Zychlix/Geiger/kluczowanie_i_sprzezenie.png

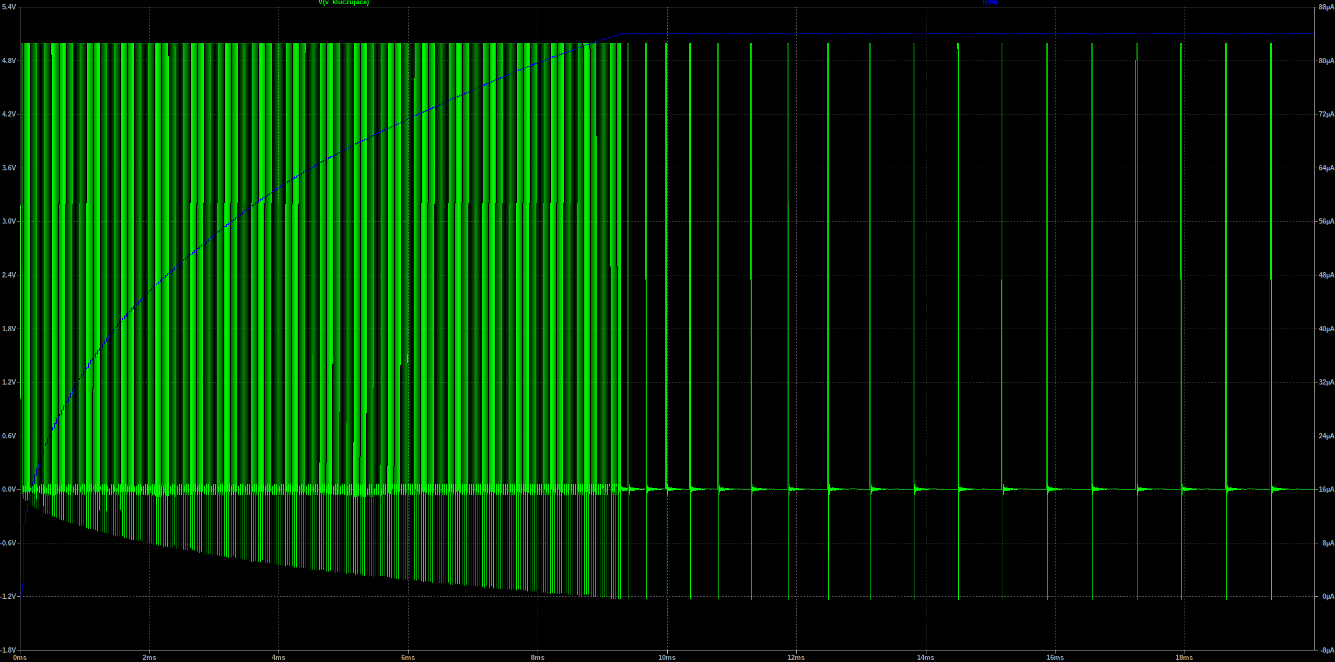
kluczowanie_i_sprzezenie.png
