Zychlix/Geiger/LGM-01_pomocnicze/schemat.png

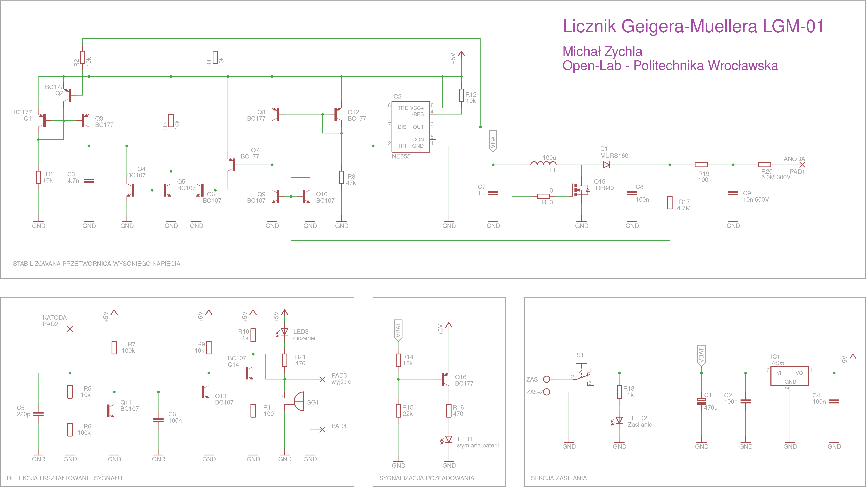
LGM-01_pomocnicze/schemat.png
