Zychlix/Geiger/oscylator.png

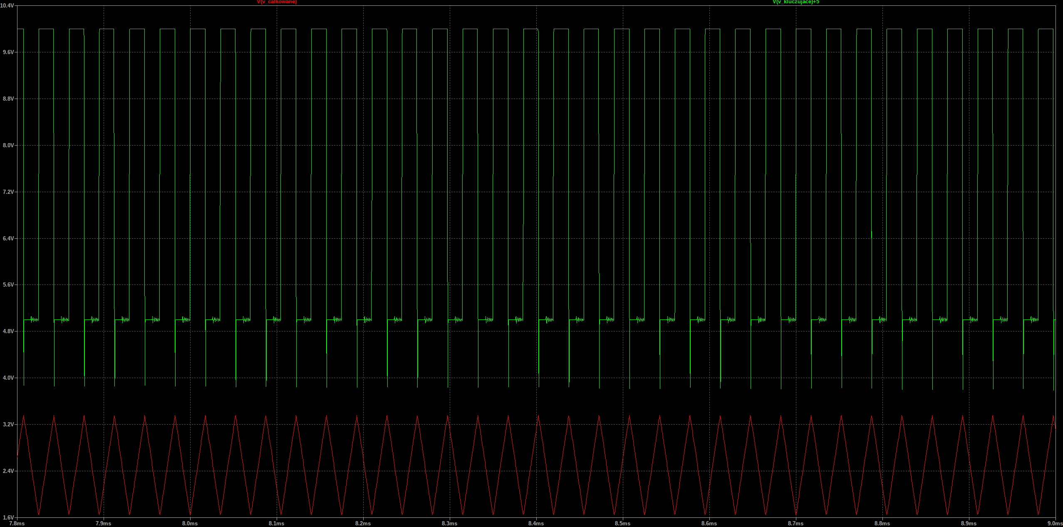
oscylator.png
