Zychlix/Geiger/załączenie_20C_bez_rl.png

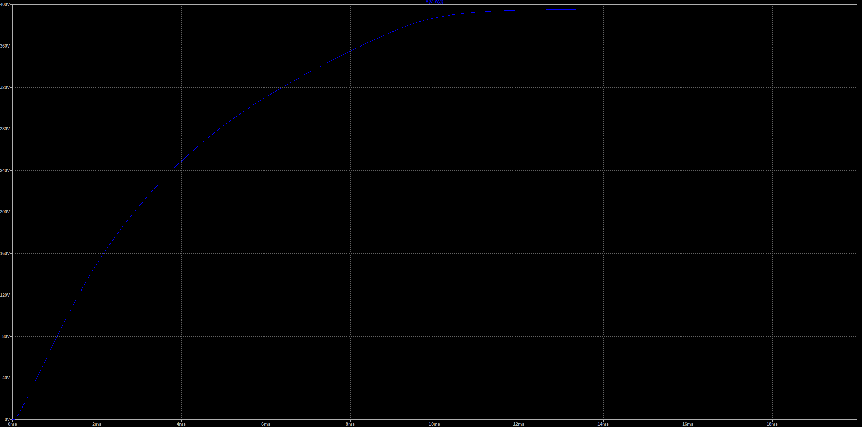
załączenie_20C_bez_rl.png
