Zychlix/Geiger/ładowanie_i_rozładowywanie.png

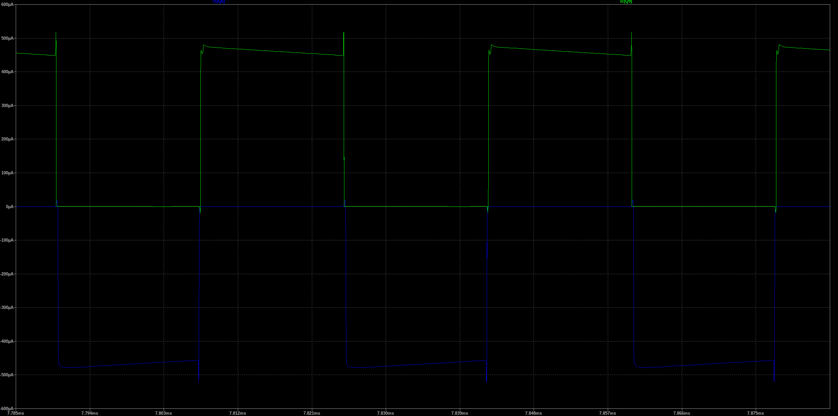
ładowanie_i_rozładowywanie.png
