Zychlix/Geiger/ładowanie_i_rozładowywanie_fb.png

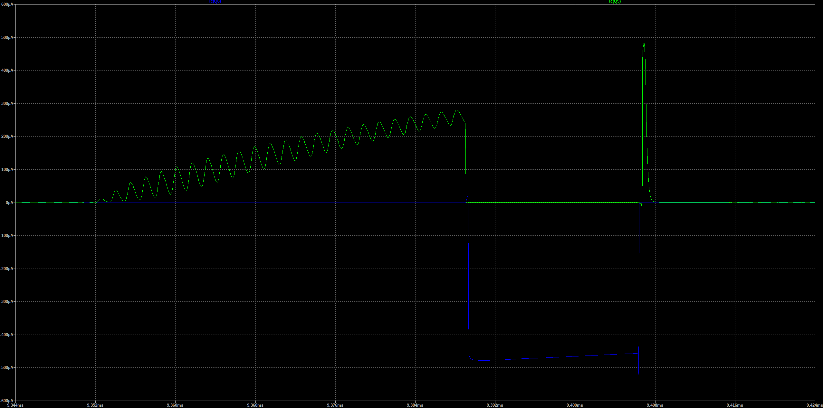
ładowanie_i_rozładowywanie_fb.png
