Zychlix/Geiger/LGM-01_pomocnicze/licznik.pdf

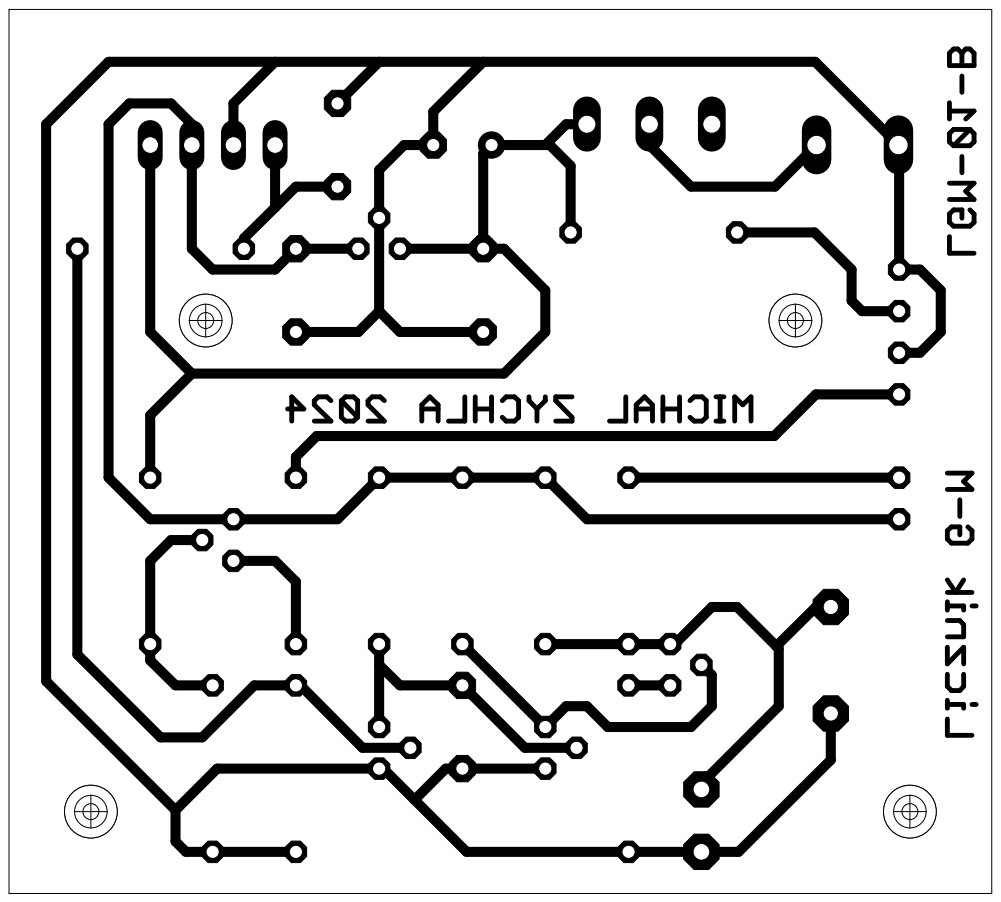
[picture p7: page 1]
