Zychlix/Geiger/LGM-01_przetwornica/licznik.pdf

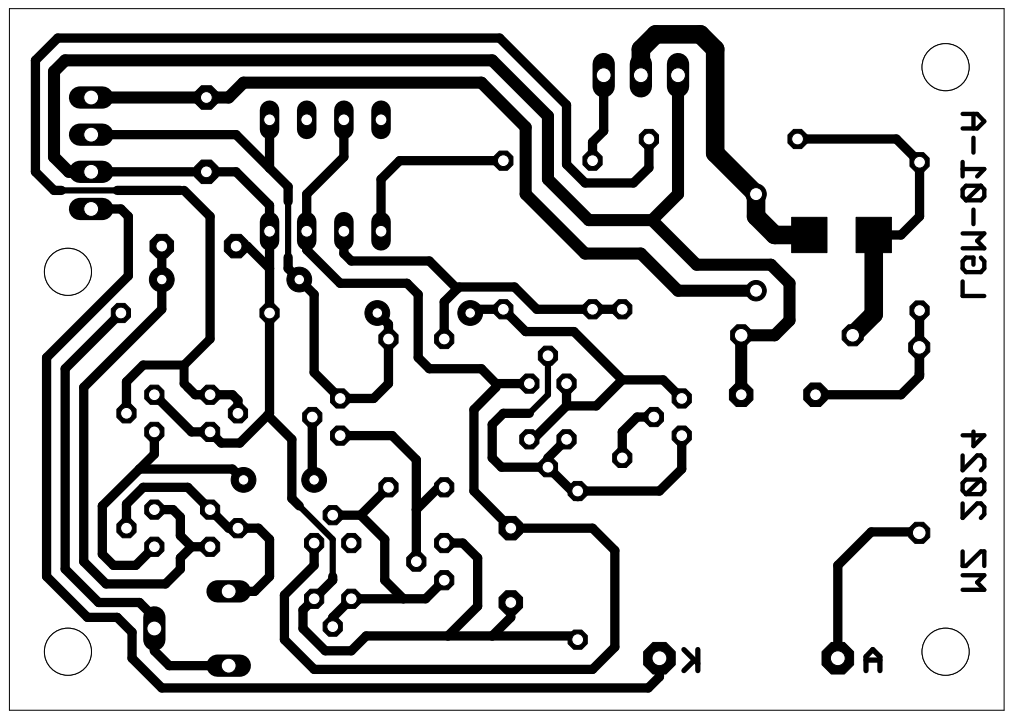
[picture p8: page 1]
