Zychlix/Geiger/dodatkowe.asc

C1: cap; 10n
C2: cap; 330p
C3: cap; 100n
D1: LED; L1C1-DRD1000000000
I1: current; PULSE(0 5 10m 1u 1u 5u 50m); load
Q1: npn; BC108B
Q2: npn; BC108B
Q3: pnp; BC178B
Q10: npn; BC108B
R1: res; 5.1Meg
R2: res; 100k
R3: res; 10k
R4: res; 100k
R5: res; 100k
R6: res; 22k
R7: res; 12k
R8: res; 10k
R9: res; 470
R13: res; 1k
R14: res; 100
V1: voltage; 400
V2: voltage; 5V
V3: voltage; 5V
V4: voltage; PULSE(8.4 5 0 100m 1m 0 100m)
Named nets: 0, WYJSCIE
.tran 0 200m 0 startup
Ukad detekcji impulsow
Wskaznik rozladowania baterii
