Zychlix/Geiger/nadajnik.asc

C1: cap; 10n
C2: cap; 220p
C3: cap; 100n
C4: cap; 22p
C5: cap; 22p
C6: cap; 1n
D1: LED; NSPW500BS
I1: current; PULSE(0 5 10m 1u 1u 5u 50m); load
L1: ind; 300n
Q1: npn; BC108B
Q2: npn; BC108B
Q3: pnp; BC178B
Q4: npn; BC108B
Q5: npn; BC108B
Q6: npn; BC108B
Q7: pnp; BC178B
Q8: pnp; BC178B
Q9: npn; BC108B
Q10: npn; BC549C
R1: res; 5.1Meg
R2: res; 100k
R3: res; 10k
R4: res; 100k
R5: res; 100k
R6: res; 22k
R7: res; 12k
R8: res; 10k
R9: res; 330
R10: res; 4.7k
R11: res; 3.3k
R12: res; 100
R13: res; 1k
R14: res; 20k
R15: res; 390
R16: res; 22
V1: voltage; 400
V2: voltage; 5V
V3: voltage; 5V
V4: voltage; PULSE(8.4 5 0 100m 1m 0 100m)
V5: voltage; PULSE(8.4 5 0 100m 1m 0 100m)
V6: voltage; 5V
V7: voltage; 9
V9: voltage; SINE(0 1 10meg 0)
Named nets: 0
.tran 0 200m 0 startup
Ukad detekcji impulsow
Wskaznik rozladowania baterii
Dodaj jeszcze zielonego leda pwr on
