Zychlix/Geiger/sekcja_zasilania.asc

10: res; 10
C1: cap; 4.7n
C2: cap; 1µ
C3: cap; 100n
C4: cap; 10n
D1: schottky; UPSC600
I1: current; PULSE(0 1m 80m 100n 100n 40m 100m)
L1: ind; 100µ; Rser=0.04
M1: nmos; IRF840
Q1: pnp; BC178B
Q2: pnp; BC178B
Q3: npn; BC108C
Q4: pnp; BC178B
Q5: npn; BC108C
Q6: pnp; BC178B
Q7: pnp; BC178B
Q8: pnp; BC178B
Q9: npn; BC108C
Q10: npn; BC108C
Q11: npn; BC108C
R1: res; 10k
R2: res; 10k
R3: res; 10k
R4: res; 4.7Meg
R5: res; 4.7Meg
R9: res; 47k
R10: res; 10k
R11: res; 100k
U1: NE555
V1: voltage; 5
V5: voltage; 6; Rser=0.1
Named nets: 0, Vcc, V_calkowane, V_kluczujace, V_wyj
.tran 0 100m 100n startup
;.temp 0 20 40
.include irf840.model
Linia stabilizowana
linia niestabilizowana
