Zychlix/Geiger/LGM-01_przetwornica/licznik.brd

## EAGLE design LGM-01_przetwornica/licznik.brd (2024-06-09)

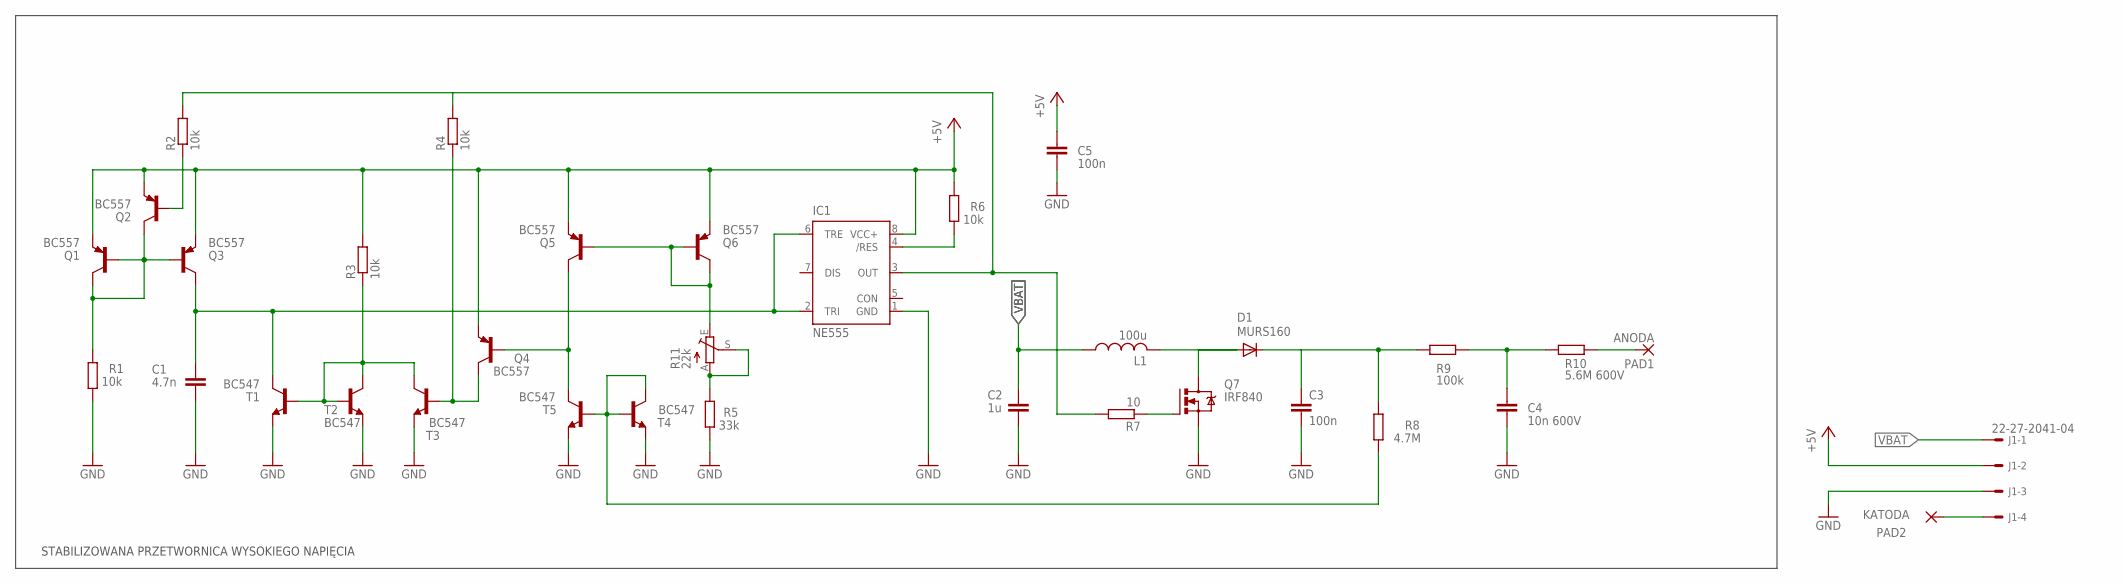
[picture p9: schematic licznik.sch]

Parts:
C1: 4.7n; C5B3
C2: 1u; C5B3
C3: 100n; C075-032X103
C4: 10n 600V; C5B3
C5: 100n; C5B3
D1: MURS160; SMB
IC1: NE555; DIL-08
J1: 22-27-2041-04; 6410-04
L1: 100u; TJ3-U1
PAD1: ANODA; 2,15/1,0
PAD2: KATODA; 2,15/1,0
Q1, Q2, Q3, Q4, Q5, Q6: BC557; TO92
Q7: IRF840; TO220BV
R1, R2, R3, R4, R6: 10k; 0207/10
R5: 33k; 0207/10
R7: 10; 0207/10
R8: 4.7M; 0207/10
R9: 100k; 0207/10
R10: 5.6M 600V; 0411/12
R11: 22k; CA6V
T1, T2, T3, T4, T5: BC547; TO92

Connections:
+5V: C5.1, IC1.8 (VCC+), J1.2, Q1.1 (E), Q2.1 (E), Q3.1 (E), Q4.1 (E), Q5.1 (E), Q6.1 (E), R3.2, R6.2
GND: C1.2, C2.2, C3.2, C4.2, C5.2, IC1.1 (GND), J1.3, Q7.S, R1.1, R5.1, T1.1 (E), T2.1 (E), T3.1 (E), T4.1 (E), T5.1 (E)
unnamed: C3.1, D1.C, R8.2, R9.2
unnamed: Q4.3 (C), R4.1, T3.2 (B)
unnamed: IC1.3 (OUT), R2.2, R4.2, R7.2
unnamed: Q1.2 (B), Q1.3 (C), Q2.3 (C), Q3.2 (B), R1.2
unnamed: C1.1, IC1.2 (TRI), IC1.6 (TRE), Q3.3 (C), T1.3 (C)
unnamed: D1.A, L1.2, Q7.D
unnamed: R3.1, T1.2 (B), T2.2 (B), T2.3 (C), T3.3 (C)
unnamed: Q2.2 (B), R2.1
unnamed: Q7.G, R7.1
unnamed: C4.1, R9.1, R10.1
unnamed: Q5.2 (B), Q6.2 (B), Q6.3 (C), R11.E
unnamed: R8.1, T4.2 (B), T5.2 (B), T5.3 (C)
unnamed: Q4.2 (B), Q5.3 (C), T4.3 (C)
unnamed: R5.2, R11.A, R11.S
unnamed: IC1.4 (/RES), R6.1
unnamed: PAD1.1, R10.2
unnamed: J1.4, PAD2.1
VBAT: C2.1, J1.1, L1.1

Notes on the sheet:
STABILIZOWANA PRZETWORNICA WYSOKIEGO NAPIĘCIA

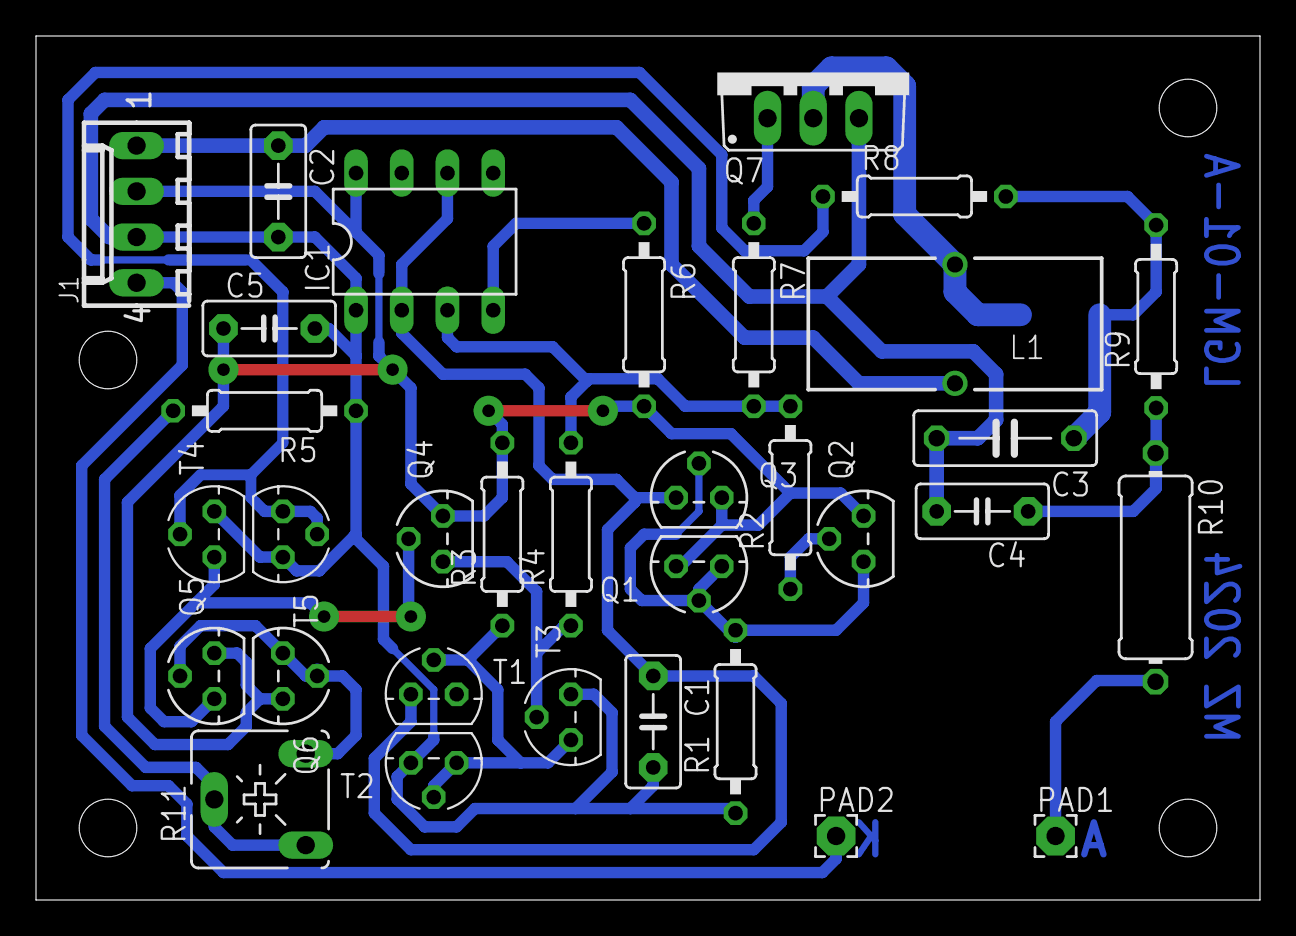
[picture p10: board LGM-01_przetwornica/licznik.brd from above]

Board: 2 copper layers, 68.0 x 48.0 mm, 34 parts (1 on the bottom side), 20 nets.
