Zychlix/Geiger/LGM-01_pomocnicze/licznik.brd

## EAGLE design LGM-01_pomocnicze/licznik.brd (2024-06-09)

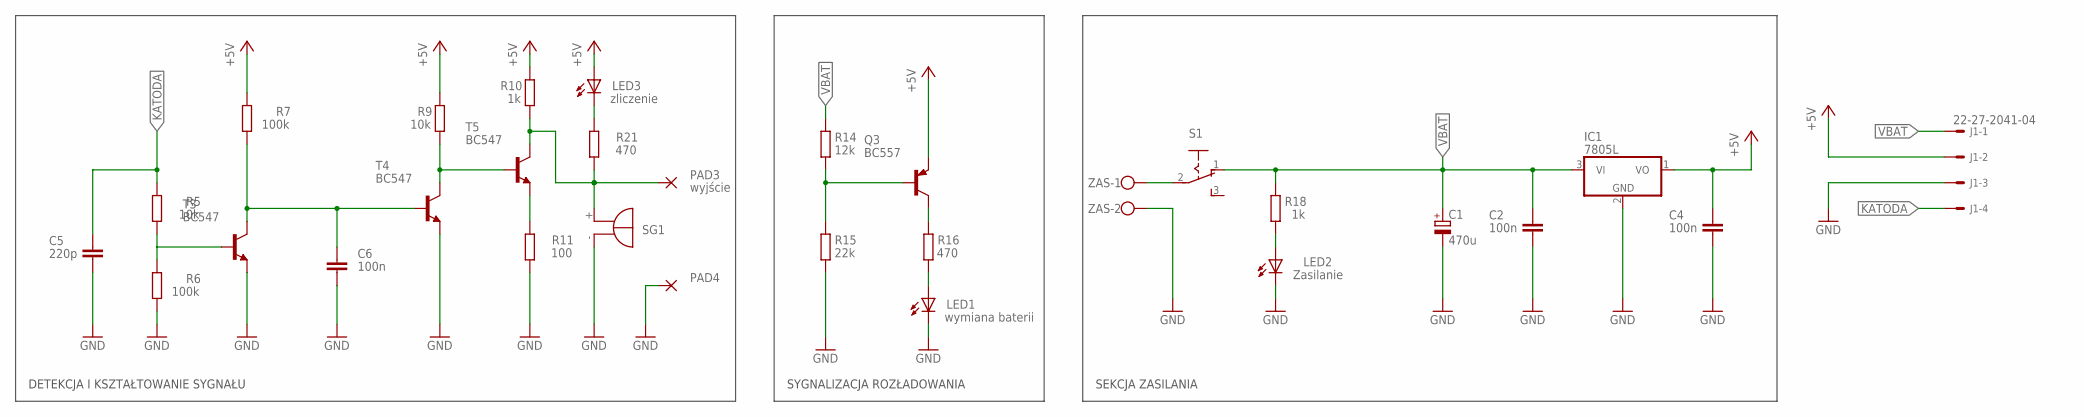
[picture p11: schematic licznik.sch]

Parts:
C1: 470u; E3,5-8
C2, C4, C6: 100n; C5B3
C5: 220p; C5B3
IC1: 7805L; TO92
J1: 22-27-2041-04; 6410-04
LED1: wymiana baterii; LED3MM
LED2: Zasilanie; LED3MM
LED3: zliczenie; LED3MM
PAD3: wyjście; 2,15/1,0
PAD4: WIREPAD2,15/1,0; 2,15/1,0
Q3: BC557; TO92
R5, R9: 10k; 0207/10
R6, R7: 100k; 0207/10
R10, R18: 1k; 0207/10
R11: 100; 0207/10
R14: 12k; 0207/10
R15: 22k; 0207/10
R16, R21: 470; 0207/10
S1: 255SB
SG1: F/QMBIII
T3, T4, T5: BC547; TO92
ZAS: W237-102

Connections:
+5V: C4.1, IC1.1 (VO), J1.2, LED3.A, Q3.1 (E), R7.2, R9.2, R10.2
GND: C1.-, C2.2, C4.2, C5.2, C6.2, IC1.2 (GND), J1.3, LED1.K (C), LED2.K (C), PAD4.1, R6.1, R11.1, R15.1, SG1.- (+), T3.1 (E), T4.1 (E), ZAS.2
KATODA: C5.1, J1.4, R5.2
unnamed: LED2.A, R18.1
unnamed: LED1.A, R16.1
unnamed: R5.1, R6.2, T3.2 (B)
unnamed: C6.1, R7.1, T3.3 (C), T4.2 (B)
unnamed: R11.2, T5.1 (E)
unnamed: S1.2, ZAS.1
unnamed: R9.1, T4.3 (C), T5.2 (B)
unnamed: Q3.3 (C), R16.2
unnamed: Q3.2 (B), R14.1, R15.2
unnamed: LED3.K (C), R21.2
VBAT: C1.+, C2.1, IC1.3 (VI), J1.1, R14.2, R18.2, S1.1 (O)
WYJSCIE: PAD3.1, R10.1, R21.1, SG1.+ (-), T5.3 (C)

Notes on the sheet:
DETEKCJA I KSZTAŁTOWANIE SYGNAŁU
SYGNALIZACJA ROZŁADOWANIA
SEKCJA ZASILANIA

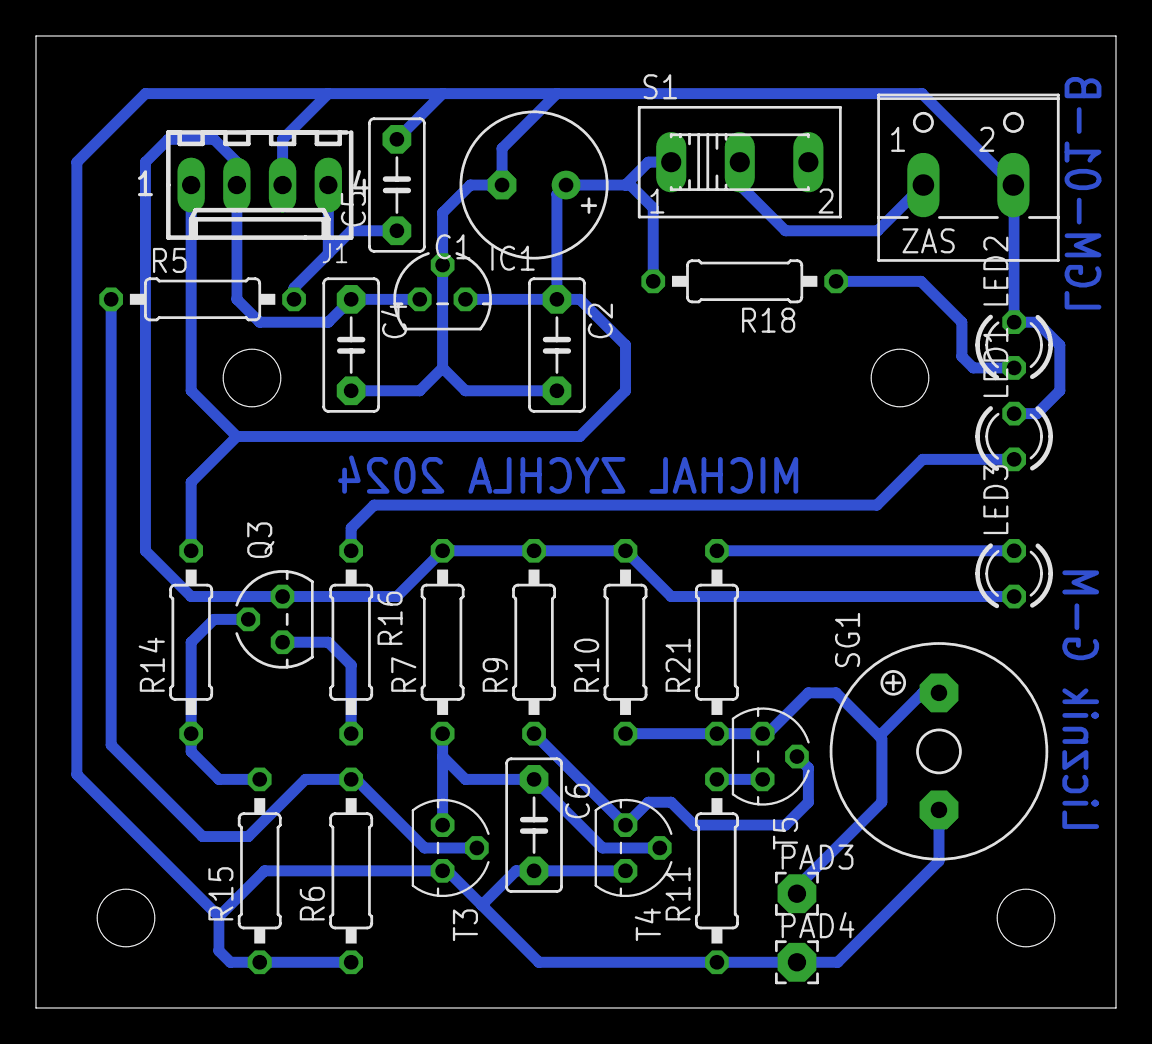
[picture p12: board LGM-01_pomocnicze/licznik.brd from above]

Board: 2 copper layers, 60.0 x 54.0 mm, 30 parts (0 on the bottom side), 15 nets.
