Zychlix/Geiger/(commit log)

2024-04-21 Geiger SMPS made
    [licznik.brd, licznik.sch]
2024-04-21 Geiger SMPS cleanup
    [licznik.brd]
2024-04-21 Added auxilary board
    [licznik.brd, licznik.sch]
2024-04-22 Boards complete
    [licznik.brd, licznik.sch]
